lzref/ComradeEncoders/README.md

# ComradeEncoders

## Simple DIY MIDI controller with 8 encoders and an integration with Ableton Live

ComradeEncoders

ComradeEncoders Ableton Live integration demo (https://www.youtube.com/watch?v=D4n___7jOlM)
