lzref/ComradeEncoders/enclosure/ComradeEncodersBottom.stl

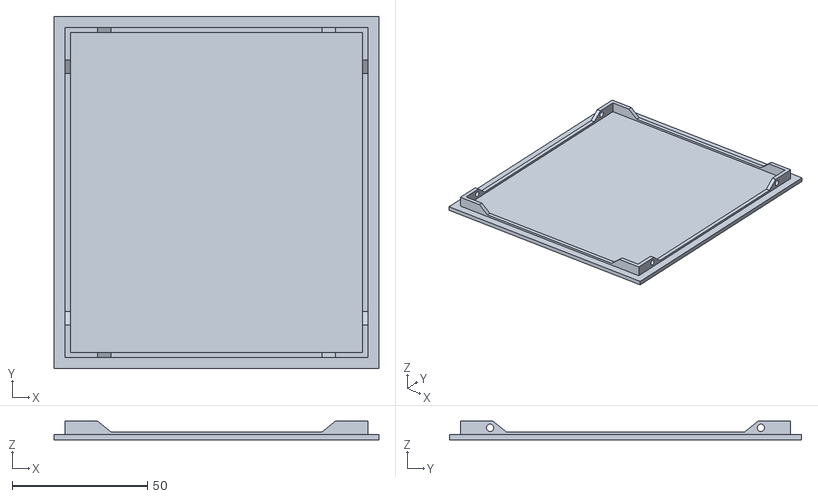
[picture p1: CAD file, 2020-12-04]
enclosure/ComradeEncodersBottom.stl
120.0 x 130.0 x 7.00
