lzref/ComradeEncoders/enclosure/ComradeEncodersTop.stl

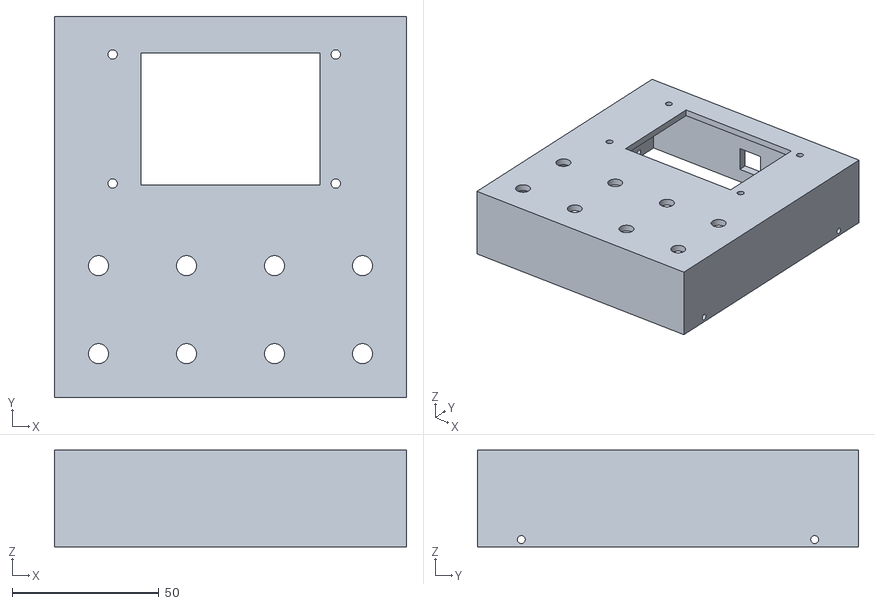
[picture p2: CAD file, 2020-11-28]
enclosure/ComradeEncodersTop.stl
120.0 x 130.0 x 33.0
