lzref/ComradeEncoders/pcb/Schematic_ComradeEncoders_v1.1.0.pdf

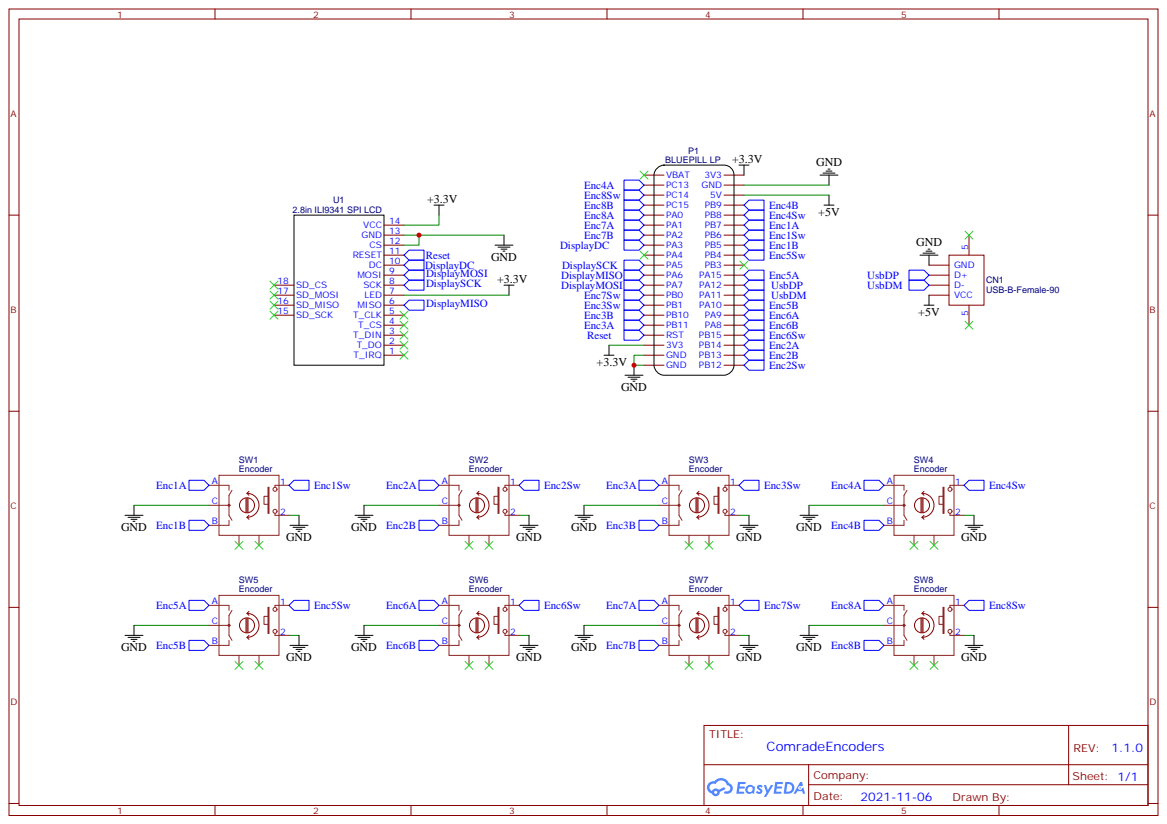
[picture p3: page 1]

DC 10 RESET 11 CS 12 GND 13 VCC 14
