lzref/ComradeEncoders/(commit log)

2020-11-21 Migrated to Platform.io.
    It's superior to Arduino IDE. It supports autocomplete and allows
    debugging.
2020-11-27 Fixed bug with first param name missing due to unsupported vPos
    [SysexParser.h, main.cpp]
2020-11-28 Different display and 8 encoders.
    1 encoder doesn't properly work though.
    Need to investigate.
    Not only the button pin interferes with Serial In
    (which is unused really but still messes us up somehow -
    but anyway, Serial debugging can be disabled in prod),
    but one of the pins is always getting a 0 for some reason.
    I thought it was a defective pin but I checked on a different
    Blue Pill board and it's the same there.
    [main.cpp]
2020-11-28 Added enclosure (only top part now)
    [ComradeEncoders.scad, ComradeEncoders.stl]
2020-12-04 Switched to using USB serial for debugging.
    I was needing one or two more pins, to avoid having to use multiplexers.
    For some reason pin PB3 doesn't work on my Blue Pill boards
    (might be a bad batch or maybe I'm doing something wrong).
    Also, I don't know if there's a way to make serial communication
    one way (so that it uses a single wire). During my tests
    I wasn't able to reliably use the other pin for buttons/encoders
    even if my program was never trying to read from serial.
    It might be possible to save one pin that goes to LCD since
    we're never reading from the LCD. However, I'm using native SPI
    capabilities of STM32 and I don't know how to make it not use
    one of the MOSI/MISO pins.
    I ha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
    [Debug.h, main.cpp]
2020-12-04 Added bottom part of the enclosure.
    The contents barely fit and the bottom part visibly bends. I'm lucky I
    was able to 3D-print with little warping, so I was able to successfully
    use metal screws on the side. But in fugure I'd try thicker bottom
    floor, taller lip for better friction, or have more screw holes.
    [ComradeEncoders.scad, ComradeEncodersBottom.stl, ComradeEncodersTop.stl]
2020-12-05 Added Ableton Live scripts.
    Ableton Live integration is based on Python scripts that Ableton uses for control surfaces.
    I based mine on Novation SL MkIII since it also has an LCD with 8 parameters mapped to encoders.
    MIDI sysex messages are used to update the display. For the most part I'm using the same MIDI messages as SL MkIII.
    This can probably be cleaned up and refactored but absolutely despise reverse-engineering Ableton's Python scripts
    and it's already working, so for now I'll just commit it as it is.
2020-12-05 Servicing encoders on a 1ms timer.
    This allows acceleration to work as intended by the library.
    Feels so much better and more responsive!
2021-09-30 First version of the PCB
    [PCB_ComradeEncoders.json, uuidMap.json]
2021-11-03 Included Adafruit GFX lib.
    Otherwise stuff doesn't compile on a clean install of PlatformIO.
    Also fixed case of "Display.h" and "Midi.h"
2021-11-05 Added schematic v1.0
2021-11-05 Adjustments for PCB 1.0.0
2021-11-07 PCB v1.1.0
    * Connected Reset pins of the display and the Blue Pill
    * Spaced encoders at 30 mm
    * Better centering of the display since the pixel area is not located symmetrically
    [uuidMap.json]
2021-11-07 Forgot to actually include the PCB! v1.1.0
    [PCB_ComradeEncoders.json]
2021-11-08 3D models for PCB components
    [PCB_ComradeEncoders.json]
